TomLerner/LEDMask-V1/constants.h

// -------------------------------------------- CUSTOM PATTERNS LIST ---------------------------------------------
// These array of indexes are used by customPattern() function in LEDMask
// They correspond to the layout and NUM_OF_LEDS in the setup

uint_least8_t bigVPattern[NUM_LEDS] = {
  // BIG V
0,  1,  2,  3,  4,  5,  6,  7,  6,  5,  4,  3,  2,  1,  0, 
  0,  1,  2,  3,  4,  5,  6,  6,  5,  4,  3,  2,  1,  0,  
    0,  1,  2,  3,  4,  5,  6,  5,  4,  3,  2,  1,  0,  
      0,  1,  2,  3,  4,  5,  5,  4,  3,  2,  1,  0,    
        0,  1,  2,  3,  4,  5,  4,  3,  2,  1,  0,    
          0,  1,  2,  3,  4,  4,  3,  2,  1,  0,            
};

uint_least8_t trianglesPattern[NUM_LEDS] = {
  // TRIANGLES
9,  8,  7,  6,  5,  4,  3,  2,  3,  4,  5,  6,  7,  8,  9, 
  8,  7,  6,  5,  4,  3,  2,  2,  3,  4,  5,  6,  7,  8,  
    7,  6,  5,  4,  3,  2,  1,  2,  3,  4,  5,  6,  7,  
      6,  5,  4,  3,  2,  1,  1,  2,  3,  4,  5,  6,    
        5,  4,  3,  2,  1,  0,  1,  2,  3,  4,  5,    
          4,  3,  2,  1,  0,  0,  1,  2,  3,  4,      
};

uint_least8_t circlesPattern[NUM_LEDS] = {
  // CIRCLES
1,  0,  6,  5,  4,  3,  2,  2,  2,  3,  4,  5,  6,  0,  1, 
  0,  6,  5,  4,  3,  2,  1,  1,  2,  3,  4,  5,  6,  0,  
    6,  5,  4,  3,  2,  1,  0,  1,  2,  3,  4,  5,  6,  
      5,  4,  3,  2,  2,  1,  1,  2,  3,  3,  4,  5,    
        5,  4,  3,  2,  2,  2,  2,  3,  3,  4,  5,    
           5,  4,  3,  2,  1,  1,  2,  3,  4,  5,         
};

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
    0, 255,255, 45,
  255, 157, 57,197};

DEFINE_GRADIENT_PALETTE( bhw1_14_gp ) {
    0,   0,  0,  0,
   12,   1,  1,  3,
   53,   8,  1, 22,
   80,   4,  6, 89,
  119,   2, 25,216,
  145,   7, 10, 99,
  186,  15,  2, 31,
  233,   2,  1,  5,
  255,   0,  0,  0};

DEFINE_GRADIENT_PALETTE( bhw1_15_gp ) {
    0,   1,  8, 87,
   71,  23,195,130,
  122, 186,248,233,
  168,  23,195,130,
  255,   1,  8, 87};

DEFINE_GRADIENT_PALETTE( bhw1_18_gp ) {
    0,   0,  0,  0,
    9,  16, 10,  7,
   53, 101, 51, 41,
   89, 194, 58, 29,
  104, 220,118, 87,
  122, 244,199,182,
  153, 194, 58, 29,
  193, 101, 51, 41,
  242,  16, 10,  7,
  255,   0,  0,  0};

DEFINE_GRADIENT_PALETTE( bhw1_22_gp ) {
    0,   1,  1,  1,
   45,  30, 10,  1,
   96,  60,  9,  1,
  130, 197, 36, 12,
  188,  30, 10,  1,
  255,   1,  1,  1};

DEFINE_GRADIENT_PALETTE( bhw1_27_gp ) {
    0,  16,  2, 50,
   61,  87, 31,180,
  114, 255,255,255,
  196,  87, 31,180,
  255, 220, 27,112};

DEFINE_GRADIENT_PALETTE( bhw1_28_gp ) {
    0,  75,  1,221,
   30, 252, 73,255,
   48, 169,  0,242,
  119,   0,149,242,
  170,  43,  0,242,
  206, 252, 73,255,
  232,  78, 12,214,
  255,   0,149,242};

DEFINE_GRADIENT_PALETTE( bhw1_32_gp ) {
    0,   0,  0,  0,
   32,   7, 12,  8,
   71,  42, 55, 45,
  108,  39,119, 73,
  130,  36,209,109,
  149,  39,119, 73,
  186,  42, 55, 45,
  230,   7, 12,  8,
  255,   0,  0,  0};

DEFINE_GRADIENT_PALETTE( bhw1_greeny_gp ) {
    0,   0,  0,  0,
   39,   7, 55,  8,
   99,  42,255, 45,
  153,   7, 55,  8,
  255,   0,  0,  0};

DEFINE_GRADIENT_PALETTE( bhw1_harvest_gp ) {
    0,   9,  5,  1,
   89, 206, 41,  4,
  132, 192, 84, 23,
  182,  65, 31,  7,
  255,   9,  5,  1};

DEFINE_GRADIENT_PALETTE( bhw1_purpgreen_gp ) {
    0,  21,  1, 35,
   27,  35, 16, 51,
   73,  54, 55, 68,
  101,  84,136, 95,
  119, 121,255,125,
  167,  59, 66, 72,
  255,  21,  1, 35};

DEFINE_GRADIENT_PALETTE( bhw1_purplered_gp ) {
    0, 255,  0,  0,
  255, 107,  1,205};

DEFINE_GRADIENT_PALETTE( bhw1_sunconure_gp ) {
    0,  20,223, 13,
  160, 232, 65,  1,
  252, 232,  5,  1,
  255, 232,  5,  1};

DEFINE_GRADIENT_PALETTE( bhw1_sunset1_gp ) {
    0,  33, 21, 25,
   38, 125, 29, 20,
   71, 222, 59, 30,
  145, 190,147,127,
  178,  88,136,203,
  255,   3, 24, 78};

DEFINE_GRADIENT_PALETTE( bhw1_sunset2_gp ) {
    0, 255,175,  8,
   81, 237, 29, 10,
  137, 148, 57, 42,
  165,  68, 54, 54,
  255,  18, 23, 29};

DEFINE_GRADIENT_PALETTE( bhw1_three_gp ) {
    0, 255,255,255,
   45,   7, 12,255,
  112, 227,  1,127,
  112, 227,  1,127,
  140, 255,255,255,
  155, 227,  1,127,
  196,  45,  1, 99,
  255, 255,255,255};

DEFINE_GRADIENT_PALETTE( bhw1_w00t_gp ) {
    0,   3, 13, 43,
  104,  78,141,240,
  188, 255,  0,  0,
  255,  28,  1,  1};

// --------------------------------------------- END CUSTOM PALETTES LIST ---------------------------------------------

  
// ------------------- PALETTE GROUPS ------------------------------  

// -------------------- Full Library -------------------------------  

//const TProgmemRGBGradientPalettePtr gGradientPalettes[] = {
//Sunset_Real_gp,
//es_ocean_breeze_036_gp,
//rgi_15_gp,
//retro2_16_gp,
//Analogous_1_gp,
//Coral_reef_gp,
//es_ocean_breeze_068_gp,
//es_vintage_01_gp,
//es_landscape_33_gp,
//gr65_hult_gp,
//GMT_drywet_gp,
//ib_jul01_gp,
//es_emerald_dragon_08_gp,
//lava_gp,
//fire_gp,
//Pink_Purple_gp,
//BlacK_Blue_Magenta_White_gp,
//BlacK_Red_Magenta_Yellow_gp,
//Blue_Cyan_Yellow_gp,
//temperature_gp,
//bhw1_03_gp,
//bhw1_04_gp,
//bhw1_05_gp,
//bhw1_06_gp,
//bhw1_11_gp,
//bhw1_13_gp,
//bhw1_14_gp,
//bhw1_15_gp,
//bhw1_18_gp,
//bhw1_22_gp,
//bhw1_27_gp,
//bhw1_28_gp,
//bhw1_32_gp,
//bhw1_greeny_gp,
//bhw1_harvest_gp,
//bhw1_purpgreen_gp,
//bhw1_purplered_gp,
//bhw1_sunconure_gp,
//bhw1_sunset1_gp,
//bhw1_sunset2_gp,
//bhw1_three_gp,
//bhw1_w00t_gp,
//    };
//
// Count of how many cpt-city gradients are defined in the full library:
//  uint8_t gGradientPalettesCount =   sizeof( gGradientPalettes) / sizeof( TProgmemRGBGradientPalettePtr );

// -------------------- Custom Circles -------------------------------  

const TProgmemRGBGradientPalettePtr gCirclesPalettes[] = {
Sunset_Real_gp,
es_ocean_breeze_036_gp,
Analogous_1_gp,
es_vintage_01_gp,
es_landscape_33_gp,
GMT_drywet_gp,
ib_jul01_gp,
fire_gp,
Pink_Purple_gp,
BlacK_Blue_Magenta_White_gp,
Blue_Cyan_Yellow_gp,
temperature_gp,
bhw1_03_gp,
bhw1_04_gp,
bhw1_05_gp,
bhw1_06_gp,
bhw1_11_gp,
bhw1_14_gp,
bhw1_15_gp,
bhw1_18_gp,
bhw1_22_gp,
bhw1_27_gp,
bhw1_32_gp,
bhw1_greeny_gp,
bhw1_harvest_gp,
bhw1_purpgreen_gp,
bhw1_sunconure_gp,
bhw1_sunset1_gp,
bhw1_w00t_gp,
    };

// Count of how many palettes in this array
 uint8_t gCirclesPalettesCount =   sizeof( gCirclesPalettes) / sizeof( TProgmemRGBGradientPalettePtr );

// -------------------- Custom Triangles -------------------------------  

const TProgmemRGBGradientPalettePtr gTrianglesPalettes[] = {
Sunset_Real_gp,
rgi_15_gp,
Analogous_1_gp,
es_vintage_01_gp,
es_landscape_33_gp,
gr65_hult_gp,
GMT_drywet_gp,
ib_jul01_gp,
es_emerald_dragon_08_gp,
lava_gp,
fire_gp,
BlacK_Blue_Magenta_White_gp,
BlacK_Red_Magenta_Yellow_gp,
Blue_Cyan_Yellow_gp,
temperature_gp,
bhw1_03_gp,
bhw1_04_gp,
bhw1_05_gp,
bhw1_06_gp,
bhw1_11_gp,
bhw1_13_gp,
bhw1_14_gp,
bhw1_15_gp,
bhw1_18_gp,
bhw1_22_gp,
bhw1_27_gp,
bhw1_28_gp,
bhw1_32_gp,
bhw1_greeny_gp,
bhw1_harvest_gp,
bhw1_purpgreen_gp,
bhw1_purplered_gp,
bhw1_sunconure_gp,
bhw1_sunset1_gp,
bhw1_sunset2_gp,
bhw1_three_gp,
bhw1_w00t_gp,
    };

// Count of how many palettes in this array
 uint8_t gTrianglesPalettesCount =   sizeof( gTrianglesPalettes) / sizeof( TProgmemRGBGradientPalettePtr );

// -------------------- Custom Outwards Wings -------------------------------  

const TProgmemRGBGradientPalettePtr gOutwardsWingsPalettes[] = {
Sunset_Real_gp,
rgi_15_gp,
Analogous_1_gp,
Coral_reef_gp,
es_vintage_01_gp,
es_landscape_33_gp,
GMT_drywet_gp,
ib_jul01_gp,
lava_gp,
fire_gp,
Pink_Purple_gp,
BlacK_Blue_Magenta_White_gp,
BlacK_Red_Magenta_Yellow_gp,
Blue_Cyan_Yellow_gp,
temperature_gp,
bhw1_03_gp,
bhw1_04_gp,
bhw1_05_gp,
bhw1_06_gp,
bhw1_11_gp,
bhw1_13_gp,
bhw1_14_gp,
bhw1_15_gp,
bhw1_18_gp,
bhw1_22_gp,
bhw1_27_gp,
bhw1_28_gp,
bhw1_purpgreen_gp,
bhw1_purplered_gp,
bhw1_sunconure_gp,
bhw1_sunset1_gp,
bhw1_three_gp,
    };

// Count of how many palettes in this array
 uint8_t gOutwardsWingsPalettesCount =   sizeof( gOutwardsWingsPalettes) / sizeof( TProgmemRGBGradientPalettePtr );

// -------------------- Custom Big V -------------------------------  

const TProgmemRGBGradientPalettePtr gBigVPalettes[] = {
Sunset_Real_gp,
es_ocean_breeze_036_gp,
rgi_15_gp,
retro2_16_gp,
Analogous_1_gp,
es_ocean_breeze_068_gp,
es_vintage_01_gp,
es_landscape_33_gp,
GMT_drywet_gp,
ib_jul01_gp,
lava_gp,
Blue_Cyan_Yellow_gp,
temperature_gp,
bhw1_03_gp,
bhw1_04_gp,
bhw1_05_gp,
bhw1_06_gp,
bhw1_11_gp,
bhw1_13_gp,
bhw1_14_gp,
bhw1_15_gp,
bhw1_18_gp,
bhw1_22_gp,
bhw1_27_gp,
bhw1_28_gp,
bhw1_32_gp,
bhw1_greeny_gp,
bhw1_harvest_gp,
bhw1_purpgreen_gp,
bhw1_purplered_gp,
bhw1_sunconure_gp,
bhw1_sunset1_gp,
bhw1_sunset2_gp,
bhw1_three_gp,
bhw1_w00t_gp,
    };

// Count of how many palettes in this array
 uint8_t gBigVPalettesCount =   sizeof( gBigVPalettes) / sizeof( TProgmemRGBGradientPalettePtr );

// -------------------- Custom Scrolling Row -------------------------------  

const TProgmemRGBGradientPalettePtr gScrollingRowPalettes[] = {
Sunset_Real_gp,
es_ocean_breeze_036_gp,
retro2_16_gp,
Analogous_1_gp,
Coral_reef_gp,
es_vintage_01_gp,
es_landscape_33_gp,
gr65_hult_gp,
GMT_drywet_gp,
ib_jul01_gp,
lava_gp,
fire_gp,
Pink_Purple_gp,
BlacK_Red_Magenta_Yellow_gp,
Blue_Cyan_Yellow_gp,
temperature_gp,
bhw1_03_gp,
bhw1_04_gp,
bhw1_05_gp,
bhw1_06_gp,
bhw1_15_gp,
bhw1_22_gp,
bhw1_27_gp,
bhw1_28_gp,
bhw1_purplered_gp,
bhw1_sunconure_gp,
bhw1_sunset1_gp,
bhw1_three_gp,
bhw1_w00t_gp,
    };

// Count of how many palettes in this array
 uint8_t gScrollingRowPalettesCount =   sizeof( gScrollingRowPalettes) / sizeof( TProgmemRGBGradientPalettePtr );

// -------------------- Custom Scrolling Column -------------------------------  

const TProgmemRGBGradientPalettePtr gScrollingColumnPalettes[] = {
Sunset_Real_gp,
es_ocean_breeze_036_gp,
rgi_15_gp,
retro2_16_gp,
Analogous_1_gp,
es_ocean_breeze_068_gp,
es_vintage_01_gp,
es_landscape_33_gp,
gr65_hult_gp,
GMT_drywet_gp,
ib_jul01_gp,
es_emerald_dragon_08_gp,
lava_gp,
fire_gp,
Pink_Purple_gp,
BlacK_Blue_Magenta_White_gp,
BlacK_Red_Magenta_Yellow_gp,
Blue_Cyan_Yellow_gp,
temperature_gp,
bhw1_03_gp,
bhw1_04_gp,
bhw1_05_gp,
bhw1_06_gp,
bhw1_13_gp,
bhw1_15_gp,
bhw1_greeny_gp,
bhw1_harvest_gp,
bhw1_purpgreen_gp,
bhw1_purplered_gp,
bhw1_sunconure_gp,
bhw1_sunset1_gp,
bhw1_w00t_gp,
    };

// Count of how many palettes in this array
 uint8_t gScrollingColumnPalettesCount =   sizeof( gScrollingColumnPalettes) / sizeof( TProgmemRGBGradientPalettePtr );

// -------------------- Custom Crossing Lines -------------------------------  

const TProgmemRGBGradientPalettePtr gCrossLinesPalettes[] = {
Sunset_Real_gp,
es_ocean_breeze_036_gp,
rgi_15_gp,
retro2_16_gp,
Analogous_1_gp,
Coral_reef_gp,
es_ocean_breeze_068_gp,
es_vintage_01_gp,
es_landscape_33_gp,
gr65_hult_gp,
GMT_drywet_gp,
ib_jul01_gp,
es_emerald_dragon_08_gp,
lava_gp,
fire_gp,
Pink_Purple_gp,
BlacK_Blue_Magenta_White_gp,
BlacK_Red_Magenta_Yellow_gp,
Blue_Cyan_Yellow_gp,
temperature_gp,
bhw1_03_gp,
bhw1_04_gp,
bhw1_05_gp,
bhw1_06_gp,
bhw1_11_gp,
bhw1_13_gp,
bhw1_14_gp,
bhw1_15_gp,
bhw1_18_gp,
bhw1_22_gp,
bhw1_27_gp,
bhw1_28_gp,
bhw1_32_gp,
bhw1_greeny_gp,
bhw1_harvest_gp,
bhw1_purpgreen_gp,
bhw1_purplered_gp,
bhw1_sunconure_gp,
bhw1_sunset1_gp,
bhw1_sunset2_gp,
bhw1_three_gp,
bhw1_w00t_gp,
    };

// Count of how many palettes in this array
 uint8_t gCrossLinesPalettesCount =   sizeof( gCrossLinesPalettes) / sizeof( TProgmemRGBGradientPalettePtr );
 
 
